CdHUFC/e-BTW/(list of files, drawings)

Other design files:
pcb/Copy of PCB1.PcbDoc
pcb/e-BTW.PrjPcb
pcb/e-BTW/e-BTW.PrjPcb
pcb/e-BTW/PCB1.PcbDoc
pcb/e-BTW/PcbLib1.PcbLib
pcb/e-BTW/Schlib1.SchLib
pcb/e-BTW/Sheet1.SchDoc
pcb/H-Bridge.SchDoc
pcb/PCB1.PcbDoc
pcb/PCB_TopSchematic.SchDoc
pcb/PcbLib1.PcbLib
pcb/Schlib1.SchLib
