CdHUFC/e-BTW/firmware/Src/main.c

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

/* Includes ------------------------------------------------------------------*/
#include "main.h"
#include "tim.h"
#include "usb_device.h"
#include "gpio.h"

/* USER CODE BEGIN Includes */
#include "brailleMatrix.h"
#include "DCMotors.h"
#include "stm32f1xx_it.h"
/* USER CODE END Includes */


/* USER CODE BEGIN PV */
#define MAX_CARACTERES 30
#define MAX_LINHAS 27
#define POS_INI 28000
#define POS_FIM 4000

char pressedEnter = 1;
char isEnd = 0;

MotorControl_t motorX;
MotorControl_t motorY;

MotorControl_Simple_t motorZ;

unsigned char buffer_char[MAX_CARACTERES];
unsigned char buffer_braille[4];
/* USER CODE END PV */

void SystemClock_Config(void);
/**
  * @brief  The application entry point.
  * @retval int
  */
int main(void)
{
  

  /* MCU Configuration--------------------------------------------------------*/

  /* Reset of all peripherals, Initializes the Flash interface and the Systick. */
  HAL_Init();

  /* Configure the system clock */
  SystemClock_Config();

  /* Initialize all configured peripherals */
  MX_GPIO_Init();
  MX_TIM2_Init();
  MX_TIM1_Init();
  MX_USB_DEVICE_Init();
  /* USER CODE BEGIN 2 */
  HAL_TIM_Encoder_Start(&htim1, TIM_CHANNEL_ALL);
  HAL_TIM_Encoder_Start(&htim2, TIM_CHANNEL_ALL);

  motorBegin(&motorX, &htim2, MOTOR_X_A_GPIO_Port, MOTOR_X_A_Pin, MOTOR_X_B_GPIO_Port, MOTOR_X_B_Pin);
  motorBegin(&motorY, &htim1, MOTOR_Y_A_GPIO_Port, MOTOR_Y_A_Pin, MOTOR_Y_B_GPIO_Port, MOTOR_Y_B_Pin);

  motorSimpleBegin(&motorZ, Motor_Z_A_GPIO_Port, Motor_Z_A_Pin, Motor_Z_B_GPIO_Port, Motor_Z_B_Pin);
  /* USER CODE END 2 */

  /* Infinite loop */
  /* USER CODE BEGIN WHILE */
  while (1)
  {
    /* USER CODE END WHILE */

    /* USER CODE BEGIN 3 */
	  //Faz a leitura do teclado e envia ao buffer_char
	  		while(1){
	  			if(keyboardAvailable(&keyboard)){
	  				HAL_GPIO_WritePin(OUTPUT_LED_GPIO_Port, OUTPUT_LED_Pin, GPIO_PIN_SET);
	  				HAL_Delay(100);
	  				HAL_GPIO_WritePin(OUTPUT_LED_GPIO_Port, OUTPUT_LED_Pin, GPIO_PIN_RESET);
	  				uint8_t c = keyboardRead(&keyboard);
	  				if(c == PS2_ENTER){
	  					pressedEnter = 1;
	  					HAL_GPIO_WritePin(OUTPUT_LED_GPIO_Port, OUTPUT_LED_Pin, GPIO_PIN_SET);
	  					break;
	  				}else if(c == PS2_DOWNARROW){
	  					updateAxis(&motorY, motorY.setPoint - 17);
	  				}else if(c == PS2_UPARROW){
	  					updateAxis(&motorY, motorY.setPoint + 17);
	  				}else if(c == PS2_LEFTARROW){
	  					updateAxis(&motorX, motorX.setPoint + 17);
	  				}else if(c == PS2_RIGHTARROW){
	  					updateAxis(&motorX, motorX.setPoint - 17);
	  				}else if(c == PS2_BACKSPACE){
	  					clearBuffer(buffer_char);
	  				}else{



	  					feedBuffer(buffer_char, MAX_CARACTERES, c);
	  				}
	  				keyboardClear(&keyboard);
	  			}
	  		}
	  		//Programa leitura do teclado
	  		if(pressedEnter){
	  			//reverse(buffer_char);
	  			uint32_t length = strlen((const char*)buffer_char);

	  			for(int j=0;j<3;j++){

	  				//Imprime as linhas em braille
	  				if(j==1){
	  					//Linhas das matrizes
	  					for(int8_t i=length-1; i>=0; --i){

	  						// Recebe os pontos da linha para o caractere atual
	  						fillLineWithBraille(buffer_braille, j,buffer_char[i]);

	  						// Percorre os 4 bits, no máximo, para cada caractere
	  						for(int8_t x = 0; x < 2; ++x){

	  							// Passa para a próxima iteração se não tem ponto para furar
	  							if(buffer_braille[x] == '1'){
	  								pierce(&motorZ, PIERCE_TIME);
	  							}

	  							if(x != 1){
	  								updateAxis(&motorX, motorX.setPoint - DELTA_COL_LIN);
	  							}

	  							// Incrementa posição do eixo x, espaçamento entre colunas

	  						}

	  						// Incrementa posição do eixo x, espaçamento entre char na horizontal
	  						if(i != 0){
	  							updateAxis(&motorX, motorX.setPoint - DELTA_CHAR_H);
	  						}


	  					}

	  					// Decrementa posição do eixo y, espaçamento entre linhas
	  					updateAxis(&motorY, motorY.setPoint - DELTA_COL_LIN);
	  					//updateAxis_Simple(&motorY, NEXT_LINE, UP);
	  				}else{

	  					//Linhas das matrizes
	  					for(int8_t i=0; i<length; i++){

	  						//Recebe os pontos da linha para o caractere atual
	  						fillLineWithBraille(buffer_braille, j,buffer_char[i]);

	  						//Percorre os 4 bits, no máximo, para cada caractere
	  						for(int8_t x = 1; x >= 0; --x){

	  							if(buffer_braille[x] == '1'){
	  								pierce(&motorZ, PIERCE_TIME);
	  							}

	  							// Incrementa posição do eixo x, espaçamento entre colunas
	  							if(x != 0){
	  								updateAxis(&motorX, motorX.setPoint + DELTA_COL_LIN);
	  							}


	  						}

	  						// Incrementa posição do eixo x, espaçamento entre char na horizontal
	  						if(i != (length -1)){
	  							updateAxis(&motorX, motorX.setPoint + DELTA_CHAR_H);
	  						}


	  					}

	  					// Incrementa posição do eixo y, espaçamento entre linhas
	  					updateAxis(&motorY, motorY.setPoint + DELTA_COL_LIN);
	  					//updateAxis_Simple(&motorY, NEXT_LINE, UP);
	  				}
	  			}

	  			//Incrementa posição do eixo y, espaçamento entre char na vertical
	  			updateAxis(&motorY, motorY.setPoint + DELTA_CHAR_V - DELTA_COL_LIN);
	  			//updateAxis_Simple(&motorY, NEXT_CHAR, UP);
	  			// Seta posição eixo x para inicial
	  			updateAxis(&motorX, POS_INI);

	  			pressedEnter = 0;
	  		}
	  		HAL_GPIO_WritePin(OUTPUT_LED_GPIO_Port, OUTPUT_LED_Pin, GPIO_PIN_RESET);
	  		keyboardClear(&keyboard);
	  		clearBuffer(buffer_char);


  }
  /* USER CODE END 3 */
}

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
