CdHUFC/e-BTW/firmware/Src/DCMotors.c

#include "DCMotors.h"
#include "tim.h"
#include "gpio.h"

void motorBegin(MotorControl_t* motor,  TIM_HandleTypeDef* timer, GPIO_TypeDef* left_port, uint16_t left_pin, GPIO_TypeDef* right_port, uint16_t right_pin){
	motor->dutyCycle = 0;
	motor->timer = timer;

	__HAL_TIM_SET_COUNTER(motor->timer,28000);
	motor->actualPoint = __HAL_TIM_GET_COUNTER(motor->timer);
	motor->setPoint = motor->actualPoint;

	motor->stepStatusOld = 0;

	motor->left_port = left_port;
	motor->right_port =  right_port;

	motor->left_pin = left_pin;
	motor->right_pin = right_pin;

	HAL_GPIO_WritePin(motor->left_port, motor->left_pin, GPIO_PIN_RESET);
	HAL_GPIO_WritePin(motor->right_port, motor->right_pin, GPIO_PIN_RESET);
}


double myABS(double num1){
	if(num1 < 0){
		num1 *= -1;
	}

	return num1;
}


void updateAxis(MotorControl_t* motor,signed long setPoint){

	// Atualiza as variaveis que vamos usar
	motor->setPoint = setPoint;
	__HAL_TIM_SET_COUNTER(motor->timer,motor->actualPoint);

	//	// Cálculo PWM - Quando está próximo do destino, diminui a velocidade do motor
	//	motor->dutyCycle = myABS((double)(motor->setPoint - motor->actualPoint)) * (double)P_FRACTION;
	//
	//	if(motor->dutyCycle < MIN_DUTYCYCLE){
	//		motor->dutyCycle = MIN_DUTYCYCLE;
	//	}else if(motor->dutyCycle > MAX_DUTYCYCLE){
	//		motor->dutyCycle = MAX_DUTYCYCLE;
	//	}
	//Verificar se é necesseário adicionar um loop para uma margem de erro
	while (myABS(motor->actualPoint - motor->setPoint) > 5){
		if(motor->actualPoint > motor->setPoint){
			// Ativa o motor para a esquerda até chegar na posição correta
			while(motor->actualPoint > motor->setPoint){
				HAL_GPIO_WritePin(motor->left_port, motor->left_pin, GPIO_PIN_SET);
				HAL_GPIO_WritePin(motor->right_port, motor->right_pin, GPIO_PIN_RESET);
				motor->actualPoint = __HAL_TIM_GET_COUNTER(motor->timer);
			}

		}else if(motor->actualPoint < motor->setPoint){
			// Ativa o motor para a direita até chegar na posição correta
			while(motor->actualPoint < motor->setPoint){
				HAL_GPIO_WritePin(motor->left_port, motor->left_pin, GPIO_PIN_RESET);
				HAL_GPIO_WritePin(motor->right_port, motor->right_pin, GPIO_PIN_SET);
				motor->actualPoint = __HAL_TIM_GET_COUNTER(motor->timer);
			}
		}

		// Desliga o motor pras duas direções
		HAL_GPIO_WritePin(motor->left_port, motor->left_pin, GPIO_PIN_RESET);
		HAL_GPIO_WritePin(motor->right_port, motor->right_pin, GPIO_PIN_RESET);

	}

	//Atualiza posição atual
	motor->actualPoint = __HAL_TIM_GET_COUNTER(motor->timer);

	return ;

}

void updateAxis_Simple(MotorControl_t* motor, uint32_t time, uint8_t direction){
	switch (direction){
		case UP:
			HAL_GPIO_WritePin(motor->left_port, motor->left_pin, GPIO_PIN_SET);
			HAL_GPIO_WritePin(motor->right_port, motor->right_pin, GPIO_PIN_RESET);
			HAL_Delay(time);
			HAL_GPIO_WritePin(motor->left_port, motor->left_pin, GPIO_PIN_RESET);
			HAL_GPIO_WritePin(motor->right_port, motor->right_pin, GPIO_PIN_RESET);
		break;
		case DOWN:
			HAL_GPIO_WritePin(motor->left_port, motor->left_pin, GPIO_PIN_RESET);
			HAL_GPIO_WritePin(motor->right_port, motor->right_pin, GPIO_PIN_SET);
			HAL_Delay(time);
			HAL_GPIO_WritePin(motor->left_port, motor->left_pin, GPIO_PIN_RESET);
			HAL_GPIO_WritePin(motor->right_port, motor->right_pin, GPIO_PIN_RESET);
		break;
		default:
			HAL_GPIO_WritePin(motor->left_port, motor->left_pin, GPIO_PIN_RESET);
			HAL_GPIO_WritePin(motor->right_port, motor->right_pin, GPIO_PIN_RESET);
		break;
	}

}
void motorSimpleBegin(MotorControl_Simple_t* motor, GPIO_TypeDef* a_port, uint16_t a_pin, GPIO_TypeDef* b_port, uint16_t b_pin){
	motor->A_PORT = a_port;
	motor->A_PIN = a_pin;

	motor->B_PORT = b_port;
	motor->B_PIN = b_pin;

	HAL_GPIO_WritePin(motor->A_PORT, motor->A_PIN, GPIO_PIN_RESET);
	HAL_GPIO_WritePin(motor->B_PORT, motor->B_PIN, GPIO_PIN_RESET);
}
//Faz o motor da pin�a ir pra frente
void motorForward(MotorControl_Simple_t* motor, uint32_t time){
	HAL_GPIO_WritePin(motor->A_PORT, motor->A_PIN, GPIO_PIN_SET);
	HAL_GPIO_WritePin(motor->B_PORT, motor->B_PIN, GPIO_PIN_RESET);
	HAL_Delay(time);

	HAL_GPIO_WritePin(motor->A_PORT, motor->A_PIN, GPIO_PIN_RESET);
	HAL_GPIO_WritePin(motor->B_PORT, motor->B_PIN, GPIO_PIN_RESET);

}
//Faz o motor da pin�a voltar para tr�s
void  motorBackward(MotorControl_Simple_t* motor, uint32_t time){
	HAL_GPIO_WritePin(motor->A_PORT, motor->A_PIN, GPIO_PIN_RESET);
	HAL_GPIO_WritePin(motor->B_PORT, motor->B_PIN, GPIO_PIN_SET);
	HAL_Delay(2*time);

	HAL_GPIO_WritePin(motor->A_PORT, motor->A_PIN, GPIO_PIN_RESET);
	HAL_GPIO_WritePin(motor->B_PORT, motor->B_PIN, GPIO_PIN_RESET);

}
//Faz o motor da pin�a furar
void pierce(MotorControl_Simple_t* motor, uint32_t time){
	motorForward(motor, time);
	motorBackward(motor, time);
	HAL_Delay(500);
}
