CdHUFC/e-BTW/(commit log)

2020-03-12 Adding pcb project, removing the interface with the keyboard and activating com vitual port
    [PCB1.PcbDoc, STM32F103C8T6--3DModel-STEP-56544.STEP, Schlib1.SchLib, e-BTW.PrjPcb]
2020-03-12 Reverting commit
    [PCB1.PcbDoc, STM32F103C8T6--3DModel-STEP-56544.STEP, Schlib1.SchLib, e-BTW.PrjPcb]
2020-03-12 Organizing files
    [PCB1.PcbDoc, PcbLib1.PcbLib, STM32F103C8T6--3DModel-STEP-56544.STEP, Schlib1.SchLib, Sheet1.SchDoc, e-BTW.PrjPcb]
2020-03-12 Inicio do esquemático da pcb
    [Copy of PCB1.PcbDoc, PCB1.PcbDoc, PcbLib1.PcbLib, Sheet1.SchDoc, e-BTW.PrjPcb]
2020-06-09 Circuitos necessários para o microcontrolador finalizados
    [Sheet1.SchDoc]
2020-06-14 Controle dos motores add
    [H-Bridge.SchDoc, PCB1.PcbDoc, Schlib1.SchLib, Sheet1.SchDoc, e-BTW.PrjPcb]
2020-07-05 PCB Finalizada
    [H-Bridge.SchDoc, PCB1.PcbDoc, PCB_TopSchematic.SchDoc, Sheet1.SchDoc, e-BTW.PrjPcb]
